balinticha/ScreenBoard/Schematics-PCB/dev.kicad_pcb

## KiCad design Schematics-PCB/dev.kicad_pcb (2025-10-29)

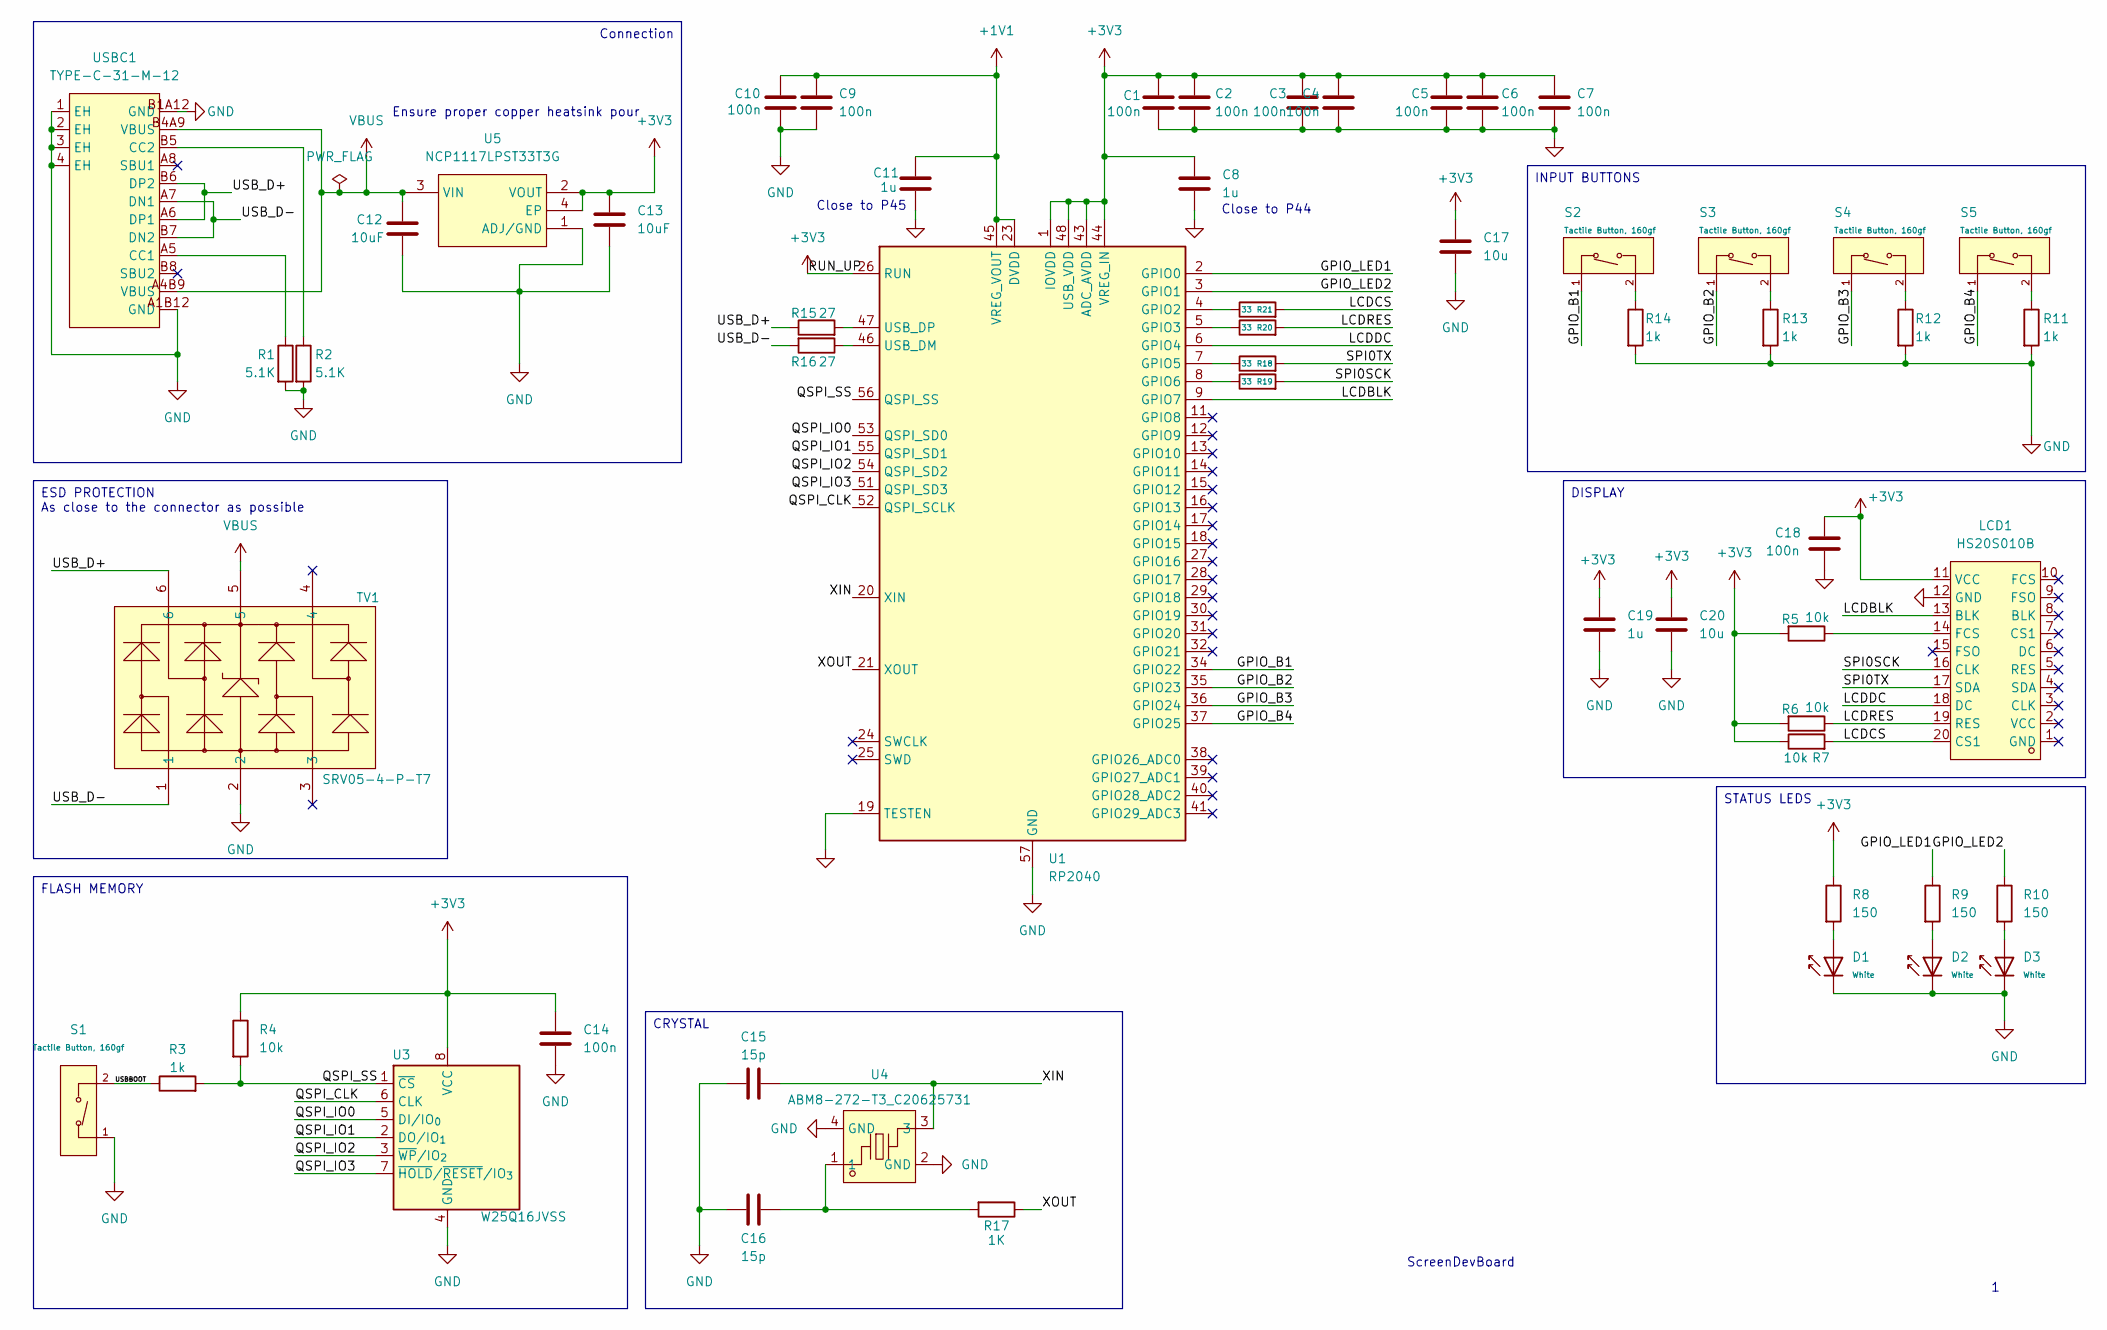
[picture p1: schematic dev.kicad_sch]

Parts:
C1, C2, C3, C4, C5, C6, C7, C9, C10: 100n; C_0402_1005Metric
C8, C11: 1u; C_0402_1005Metric
C12, C13: 10uF; C_0603_1608Metric
C14, C18: 100n; C_0603_1608Metric
C15, C16: 15p; C_0402_1005Metric
C17, C20: 10u; C_0603_1608Metric
C19: 1u; C_0603_1608Metric
D1, D2, D3: White; D_0805; Part KT-0805W; LCSC C34499
LCD1: HS20S010B; LCD-TH_HS20S010B; LCSC Part C5329586
R1, R2: 5.1K; R_0402_1005Metric
R3, R11, R12, R13, R14: 1k; R_0603_1608Metric
R4, R5, R6, R7: 10k; R_0603_1608Metric
R8, R9, R10: 150; R_0603_1608Metric
R15, R16: 27; R_0402_1005Metric
R17: 1K; R_0402_1005Metric
R18, R19, R20, R21: 33; R_0402_1005Metric
S1, S2, S3, S4, S5: Tactile Button, 160gf; SW_TS-1088-AR02016; Voltage Rating (Dc) 12V; Part TS-1088-AR02016; LCSC C720477
TV1: SRV05-4-P-T7; SOT-23-6_L2.9-W1.6-P0.95-LS2.8-BR; LCSC Part C85364
U1: RP2040; QFN-56-1EP_7x7mm_P0.4mm_EP3.2x3.2mm_ThermalVias; LCSC C2040
U3: W25Q16JVSS; SOIC-8_5.3x5.3mm_P1.27mm
U4: ABM8-272-T3_C20625731; CRYSTAL-SMD_4P-L3.2-W2.5-BL; LCSC Part C20625731
U5: NCP1117LPST33T3G; SOT-223_L6.5-W3.5-P2.30-LS7.0-BR; LCSC Part C146799
USBC1: TYPE-C-31-M-12; USB-C_SMD-TYPE-C-31-M-12_1; LCSC Part C165948

Connections:
+1V1: C9.1, C10.1, C11.1, U1.23 (DVDD), U1.45 (VREG_VOUT), U1.50 (DVDD)
+3V3: C1.1, C2.1, C3.1, C4.1, C5.1, C6.1, C7.1, C8.1, C13.1, C14.1, C17.1, C18.2, C19.1, C20.1, LCD1.11 (VCC), R4.1, R5.2, R6.2, R7.1, R8.1, U1.1 (IOVDD), U1.10 (IOVDD), U1.22 (IOVDD), U1.26 (RUN), U1.33 (IOVDD), U1.42 (IOVDD), U1.43 (ADC_AVDD), U1.44 (VREG_IN), U1.48 (USB_VDD), U1.49 (IOVDD), U3.8 (VCC), U5.2 (VOUT), U5.4 (EP)
/GPIO_B1: S2.1 (A), U1.34 (GPIO22)
/GPIO_B2: S3.1 (A), U1.35 (GPIO23)
/GPIO_B3: S4.1 (A), U1.36 (GPIO24)
/GPIO_B4: S5.1 (A), U1.37 (GPIO25)
/GPIO_LED1: R9.1, U1.2 (GPIO0)
/GPIO_LED2: R10.1, U1.3 (GPIO1)
/LCDBLK: LCD1.13 (BLK), U1.9 (GPIO7)
/LCDCS: LCD1.20 (CS1), R7.2, R21.2
/LCDDC: LCD1.18 (DC), U1.6 (GPIO4)
/LCDRES: LCD1.19 (RES), R6.1, R20.2
/QSPI_CLK: U1.52 (QSPI_SCLK), U3.6 (CLK)
/QSPI_IO0: U1.53 (QSPI_SD0), U3.5 (DI/IO_{0})
/QSPI_IO1: U1.55 (QSPI_SD1), U3.2 (DO/IO_{1})
/QSPI_IO2: U1.54 (QSPI_SD2), U3.3 (~WP/IO_{2})
/QSPI_IO3: U1.51 (QSPI_SD3), U3.7 (~HOLD/~RESET/IO_{3})
/QSPI_SS: R3.2, R4.2, U1.56 (QSPI_SS), U3.1 (~CS)
/SPI0SCK: LCD1.16 (CLK), R19.2
/SPI0TX: LCD1.17 (SDA), R18.2
/USBBOOT: R3.1, S1.2 (B)
/USB_D+: R15.1, TV1.6, USBC1.A6 (DP1), USBC1.B6 (DP2)
/USB_D-: R16.2, TV1.1, USBC1.A7 (DN1), USBC1.B7 (DN2)
/XIN: C15.2, U1.20 (XIN), U4.3
/XOUT: R17.1, U1.21 (XOUT)
GND: C1.2, C2.2, C3.2, C4.2, C5.2, C6.2, C7.2, C8.2, C9.2, C10.2, C11.2, C12.2, C13.2, C14.2, C15.1, C16.1, C17.2, C18.1, C19.2, C20.2, D1.1, D2.1, D3.1, LCD1.12 (GND), R1.2, R2.2, R11.2, R12.2, R13.2, R14.2, S1.1 (A), TV1.2, U1.19 (TESTEN), U1.57 (GND), U3.4 (GND), U4.2 (GND), U4.4 (GND), U5.1 (ADJ/GND), USBC1.1 (EH), USBC1.2 (EH), USBC1.3 (EH), USBC1.4 (EH), USBC1.A1B12 (GND), USBC1.B1A12 (GND)
unnamed: C16.2, R17.2, U4.1
unnamed: D1.2, R8.2
unnamed: D2.2, R9.2
unnamed: D3.2, R10.2
unnamed: LCD1.14 (FCS), R5.1
unnamed: R14.1, S2.2 (B)
unnamed: R13.1, S3.2 (B)
unnamed: R12.1, S4.2 (B)
unnamed: R11.1, S5.2 (B)
unnamed: R21.1, U1.4 (GPIO2)
unnamed: R20.1, U1.5 (GPIO3)
unnamed: R18.1, U1.7 (GPIO5)
unnamed: R19.1, U1.8 (GPIO6)
unnamed: R16.1, U1.46 (USB_DM)
unnamed: R15.2, U1.47 (USB_DP)
unnamed: R1.1, USBC1.A5 (CC1)
unnamed: R2.1, USBC1.B5 (CC2)
VBUS: C12.1, TV1.5, U5.3 (VIN), USBC1.A4B9 (VBUS), USBC1.B4A9 (VBUS)

Notes on the sheet:
Ensure proper copper heatsink pour
Close to P45
Close to P44
ScreenDevBoard
Connection
DISPLAY
STATUS LEDS
FLASH MEMORY
ESD PROTECTION As close to the connector as possible
INPUT BUTTONS
CRYSTAL

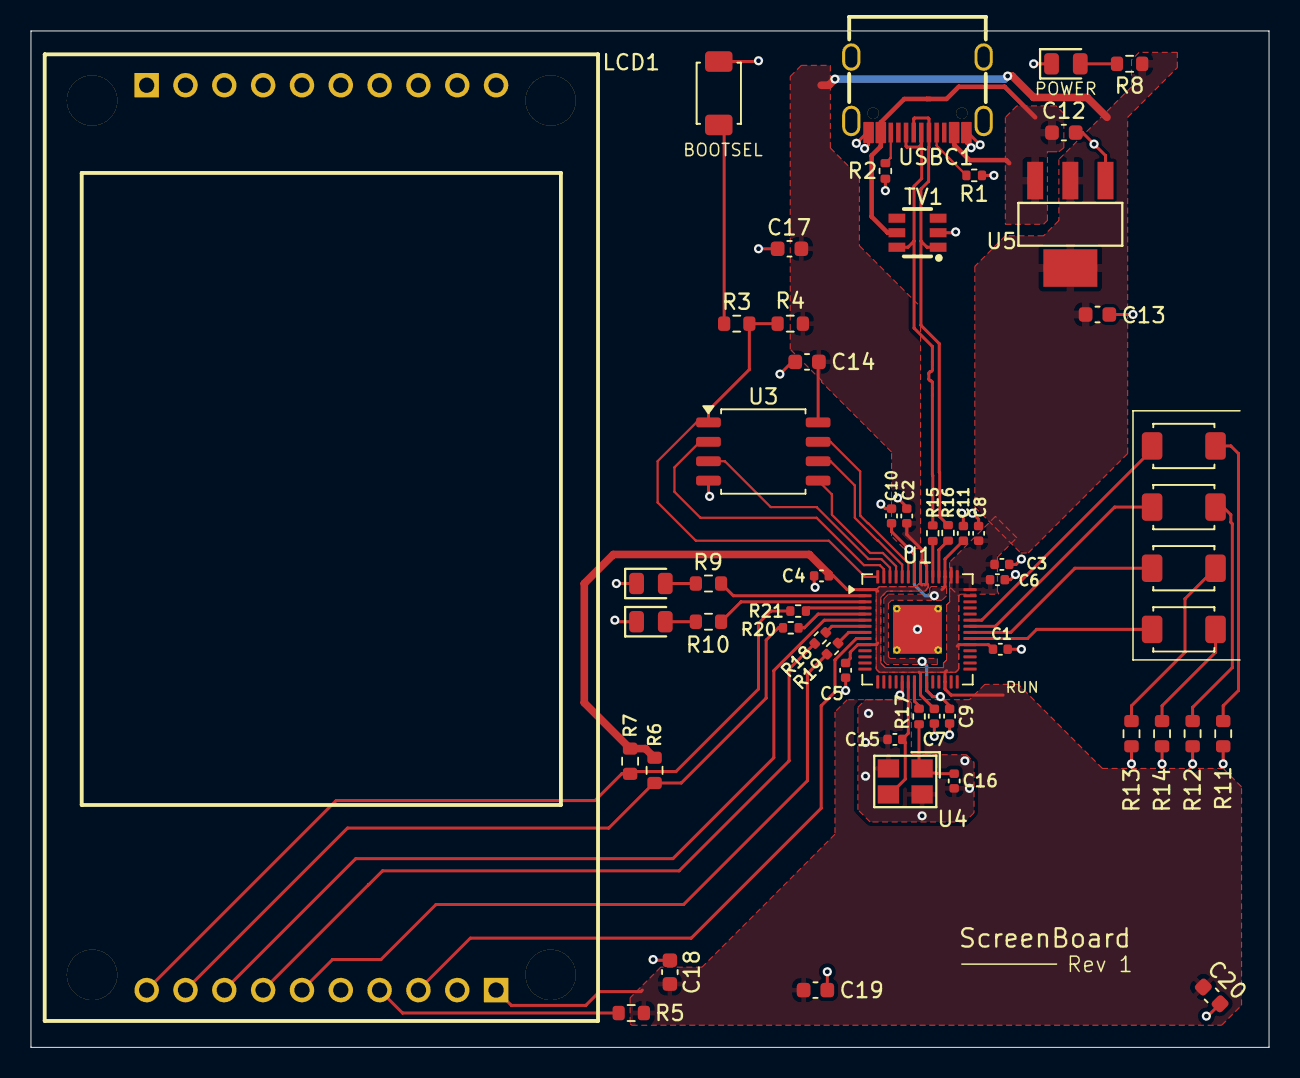
[picture p2: board dev.kicad_pcb from above]

Board: 2 copper layers, 81.0 x 66.5 mm, 56 parts (0 on the bottom side), 44 nets.
